psu-epl/epl-badge-access/README.md

# epl-badge-access

This is a mono-repo that contains hardwire designs, software, and documentation for a complete dual-band RFID access control system. This repo represents the work produced by ECE capstone team 17 during the 2021 - 2022 academic year.
