psu-epl/epl-badge-access/hardware/antenna/1356M/RFID-HF-antenna.pdf

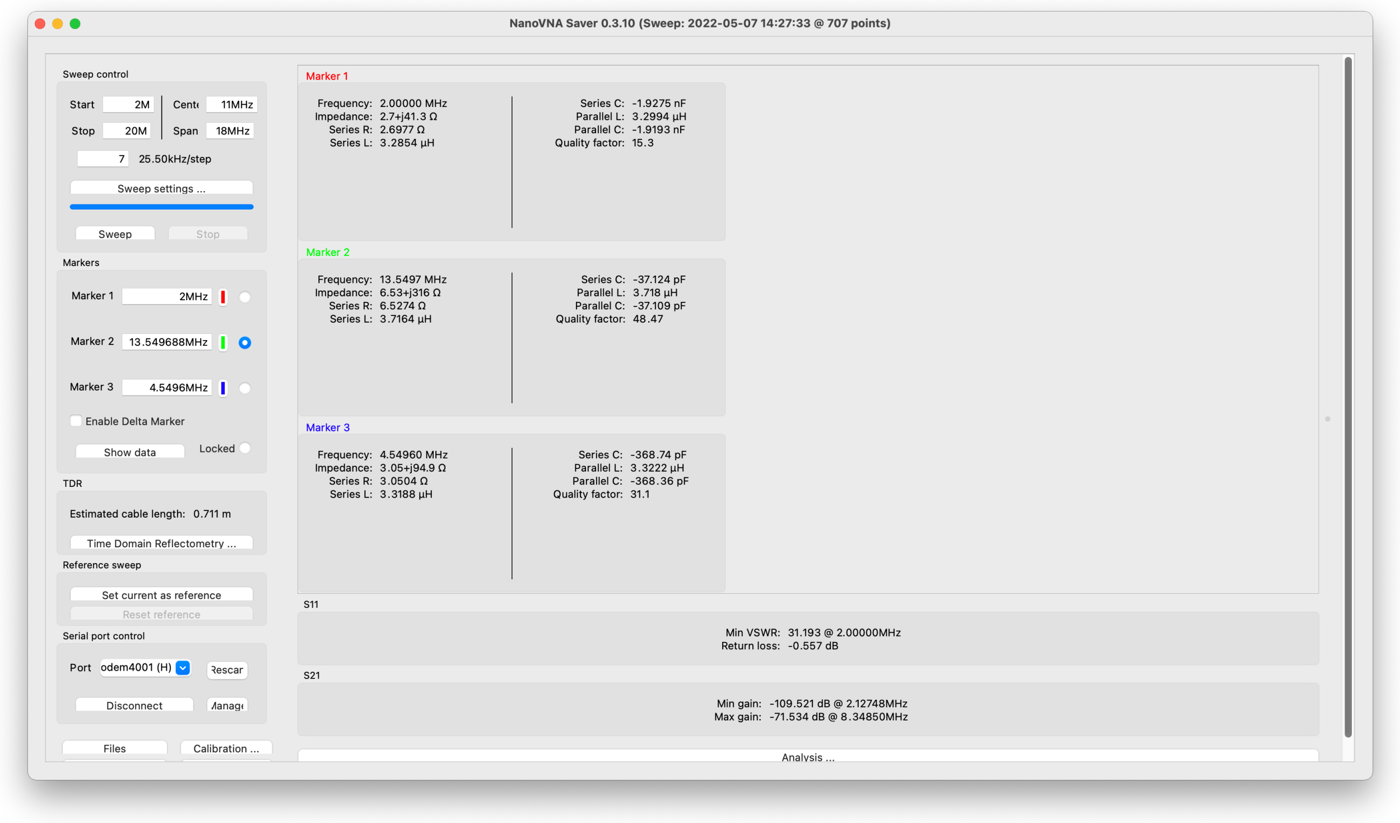
[picture p1: page 1]
