psu-epl/epl-badge-access/hardware/antenna/125k/RFID-LF-antenna.pdf

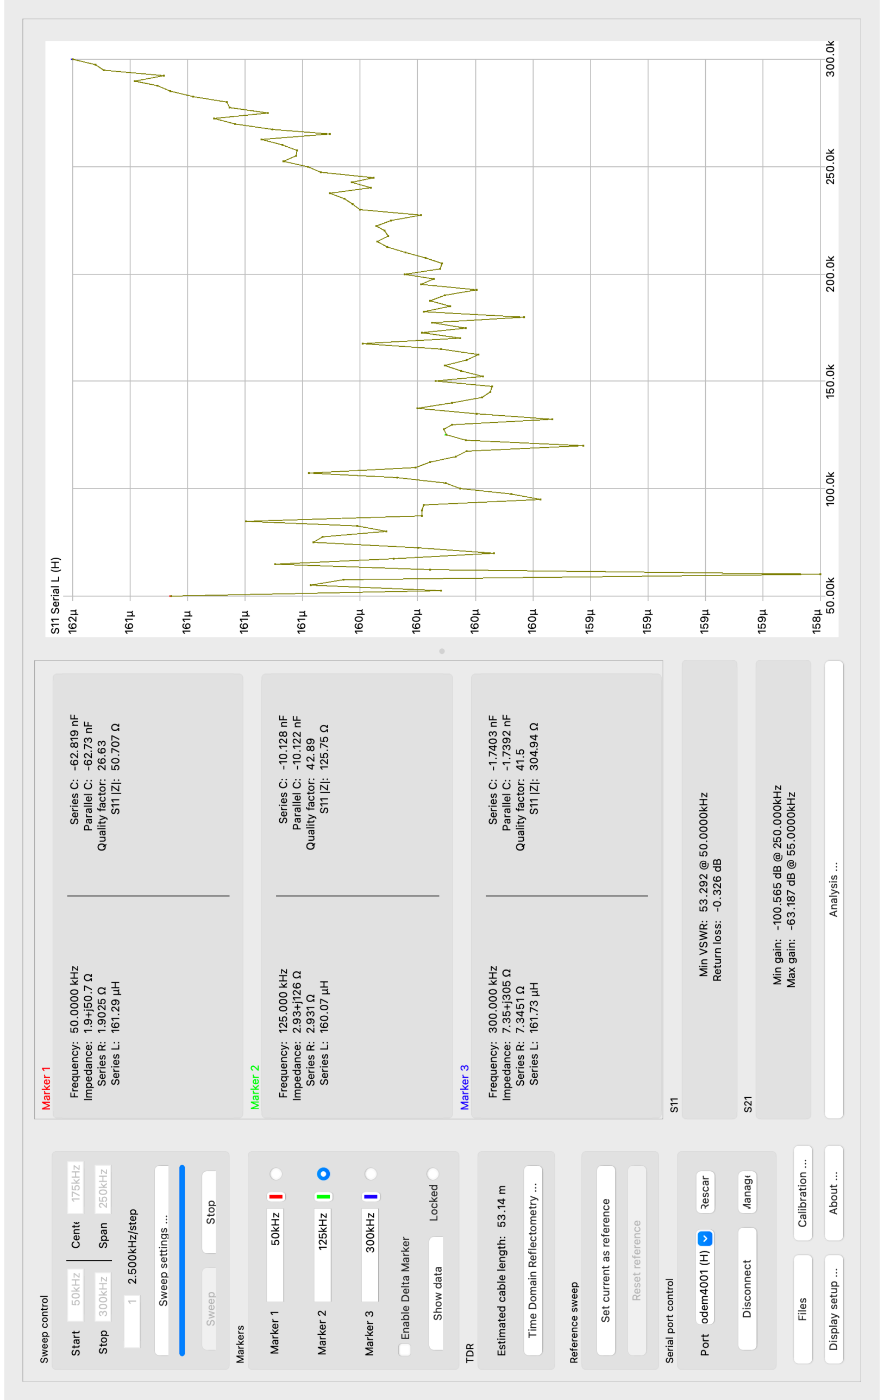
[picture p2: page 1]
