psu-epl/epl-badge-access/hardware/antenna/1356M/149110.xls

given
 | f | 13.56 | MHz
 | omega | 85199992.77 | 1/s
measured |  |  |  |  |  |  | 1 | 2 | 3 | 4
 | La | 2700 | nH |  |  |  | 0.09987919287 | 0.009975853167 | 0.2271431807 | 0.05159402454
 | Ca | 0.1 | pF
 | Ra | 2.2 | Ohm
required
 | Q | 19.8
 | Rmatch (Tx1-Tx2) | 43 | Ohm
 | fres filter | 14.400 | MHz | real: | 14.293 | MHz
calulated
 | Qa | 104.5636275
 | Rq | 4.71 | Ohm
 | Rpa | 4554.791613 | Ohm
Hilfswert |  | 4554.791613
chosen | L0 | 1000 | nH
 | C0 calculated | 122.2 | pF
chosen | C01 | 68 | pF
 | C02 | 56 | pF
 | Rtr | 698.3934612 | Ohm
 | Xtr | 117.7890312 | Ohm
 | C1 | 12.3 | pF
 | C2 | 88.7 | pF
