psu-epl/epl-badge-access/hardware/antenna/125k/RFID-LF-antenna.png

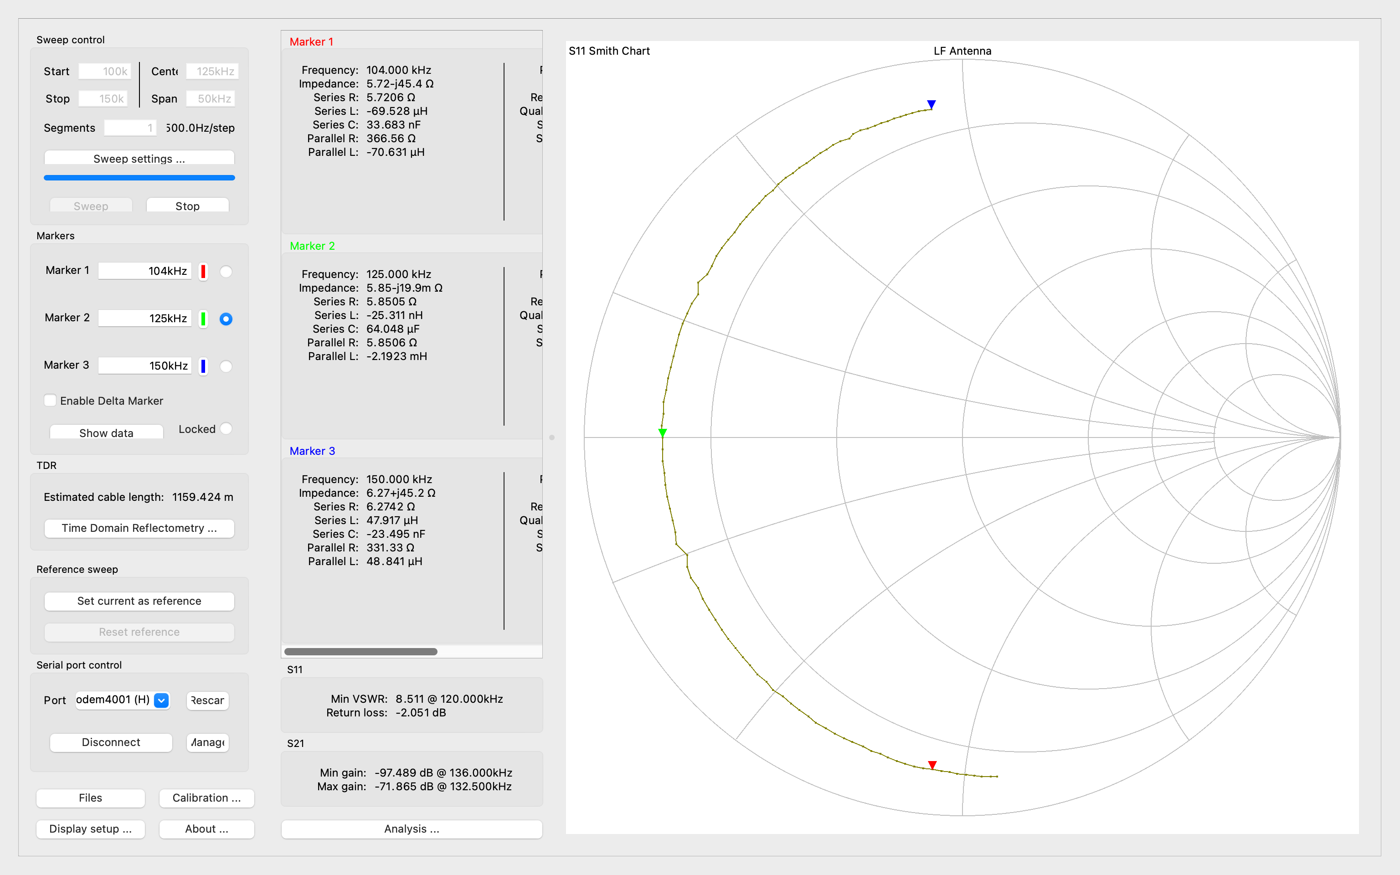
hardware/antenna/125k/RFID-LF-antenna.png
