psu-epl/epl-badge-access/hardware/antenna/1356M/rev0.1.0/VNA Measured L.pdf

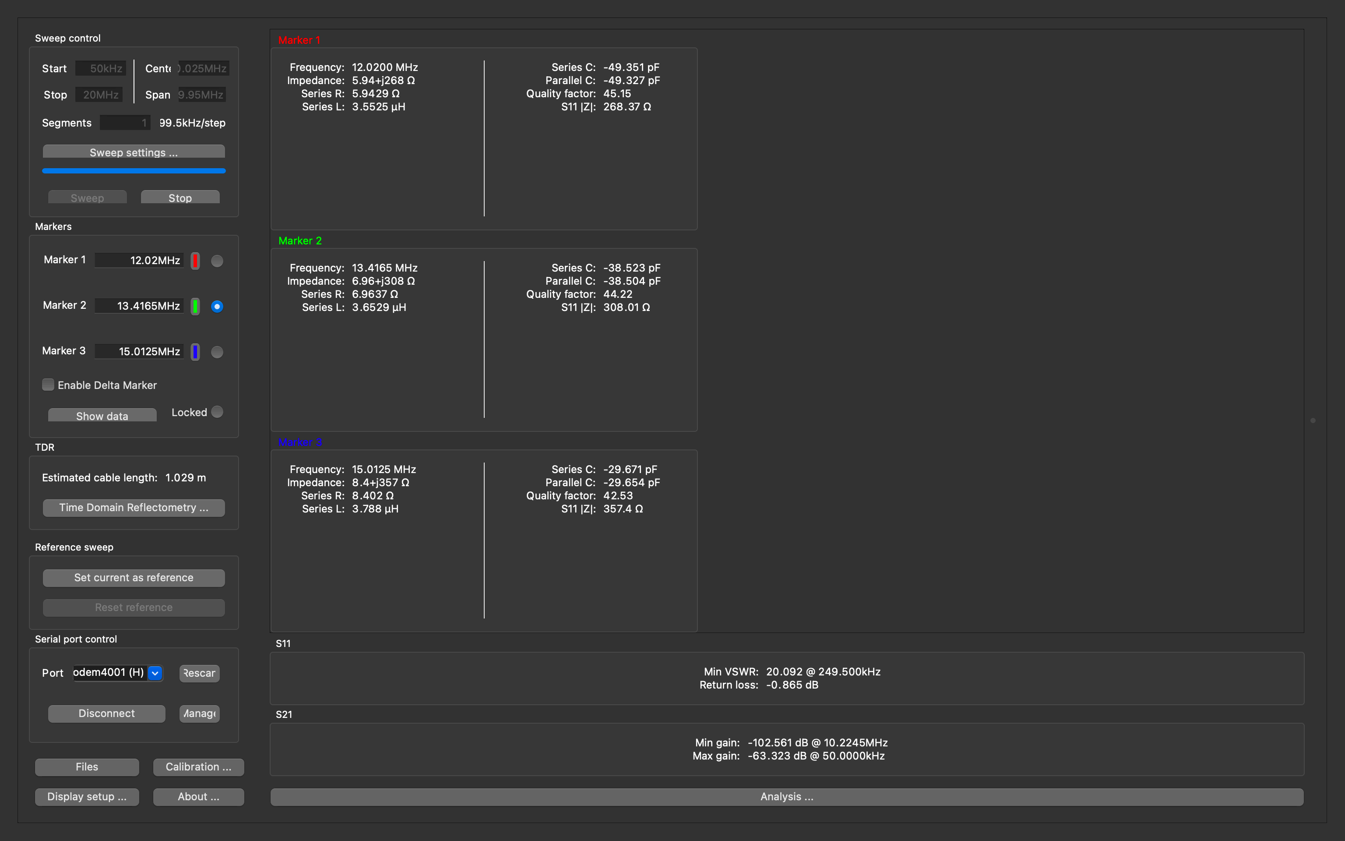
[picture p4: page 1]
