psu-epl/epl-badge-access/(threads)

Thread 3 (2022-05-07):

main board headers too tall

actaeon, 2022-05-07:
The profile of the main board headers (J1, J2 and L1) are too tall and won't fit in the enclosure. Need to find an alternative

Thread 4 (2022-05-07):

Missing Crx from receive path

actaeon, 2022-05-07:
The antenna design guide has a DC blocking cap referenced Crx in the receive path from the HF antenna. This was accidentally omitted from the design and needs to be fixed.

Thread 5 (2022-05-09):

on MFRC522, EA and I2C are backwards

actaeon, 2022-05-09:
Correct configuration is:

Pin 1 = I2C -> Connect to ground
pin 32 = EA -> pull up from 3.3V
