psu-epl/epl-badge-access/hardware/ltspice/125k/125k_reader_sim.asc

C1: cap; 162.1n
C2: cap; 1n
C3: cap; .0022µ
C4: cap; 1n
C5: cap; 1n
C6: cap; 1n
C7: cap; 1n
C8: cap; 1n
C9: cap; 1n
C10: cap; 1n
D1: diode; 1N4936
L1: ind2; 10µ; Rser=.1
L2: ind2; 1.62m
Q1: npn; 2N3904
R1: res; 1k
R2: res; 390k
R3: res; 82.5k
R4: res; 47.5k
R5: res; 100
R6: res; 2.67k
R7: res; 1.82k
R8: res; 1Meg
R9: res; 10k
R10: res; 15.5k
R11: res; 10k
R12: res; 10k
R13: res; 12k
R14: res; 10k
U1: LT1058
U2: LT1058
U3: LT1058
U4: LT1058
V1: voltage; PULSE(0 12 0 1n 1n 4u 8u)
V2: voltage; PWL REPEAT FOREVER (file="data.txt") ENDREPEAT
V3: voltage; 12
V4: voltage; 5
V5: voltage; 5
V6: voltage; 4.4
Named nets: 0, Vref, Vcc, VrefN
.tran 10m
K1 L1 L2 .1
.MODEL 1N4936 D  ( IS=830n RS=34.0m BV=400 IBV=5.00u
+ CJO=26.5p  M=0.333 N=2.46 TT=288n )
input impedance = 1M
