psu-epl/epl-badge-access/hardware/kicad/Labpass RFID Reader - Mez/Labpass RFID Reader - Mez.kicad_pcb

## KiCad design hardware/kicad/Labpass RFID Reader - Mez/Labpass RFID Reader - Mez.kicad_pcb (2022-06-10)

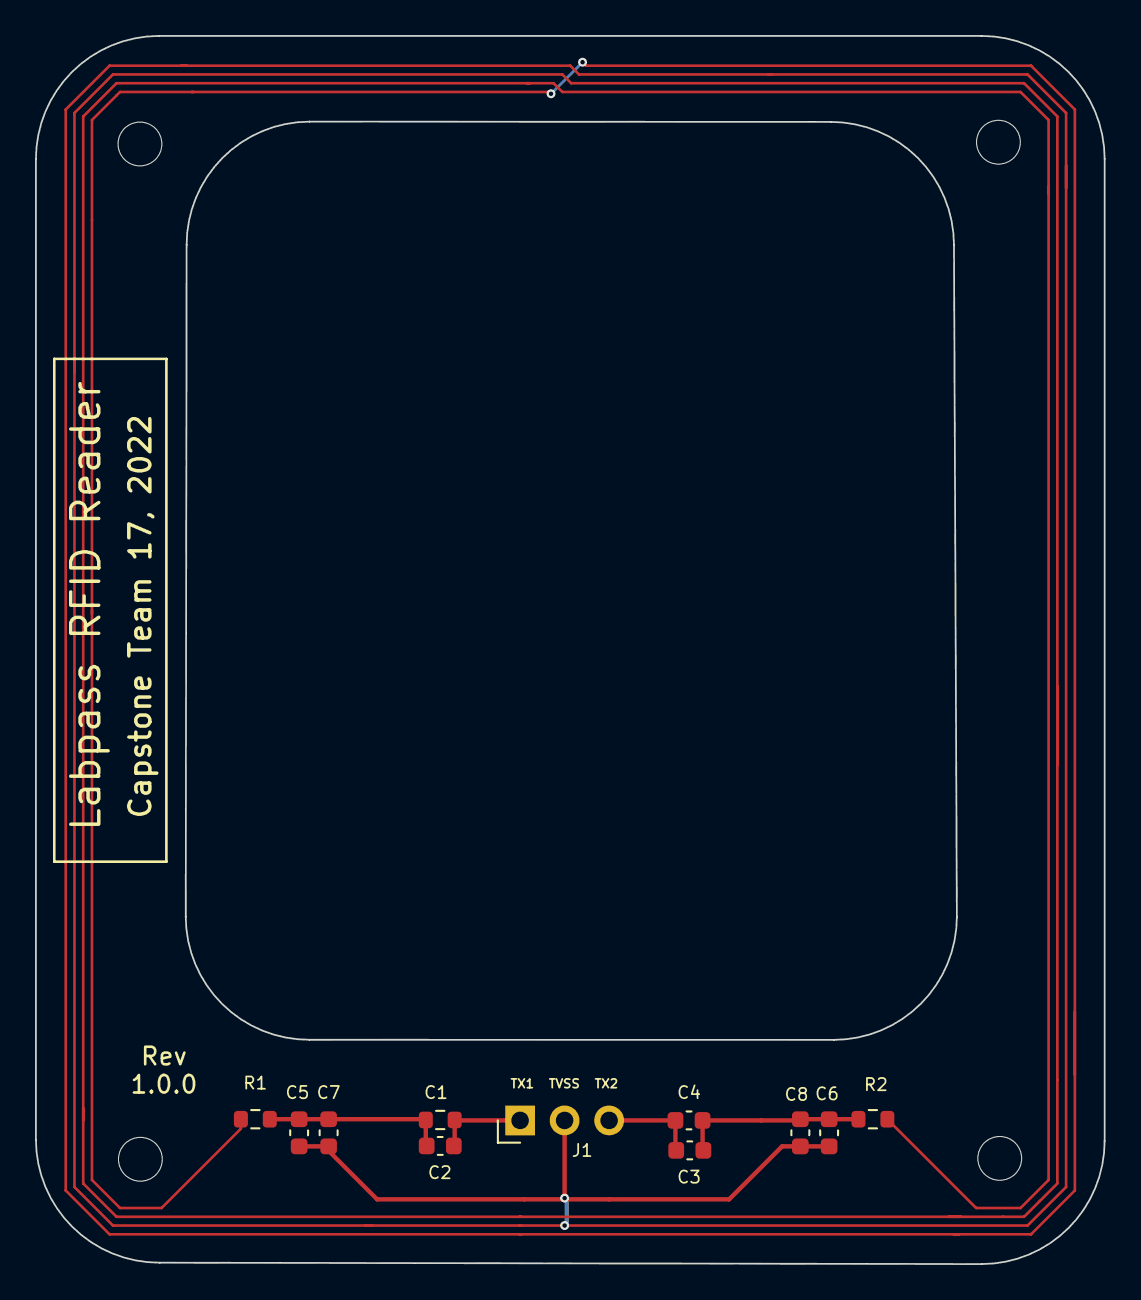
[picture p5: board Labpass RFID Reader - Mez.kicad_pcb from above]

Board: 2 copper layers, 61.0 x 70.1 mm, 11 parts (0 on the bottom side), 5 nets.

Parts:
C1: 11p; R_0603_1608Metric
C2, C3: NC; C_0603_1608Metric
C4: 11p; C_0603_1608Metric
C5, C6: 30p; C_0603_1608Metric
C7, C8: 32p; C_0603_1608Metric
J1: Conn_01x03_Male; PinHeader_1x03_P2.54mm_Horizontal
R1, R2: R_US; R_0603_1608Metric

Connections:
unnamed: C1.1, C2.1, J1.1
unnamed: C1.2, C2.2, C5.2, C7.1, R1.1
unnamed: C3.1, C4.1, J1.3
unnamed: C3.2, C4.2, C6.1, C8.2, R2.1
unnamed: C5.1, C6.2, C7.2, C8.1, J1.2, R1.2, R2.2
