psu-epl/epl-badge-access/hardware/kicad/Labpass RFID Reader/Labpass RFID Reader.kicad_pcb

## KiCad design hardware/kicad/Labpass RFID Reader/Labpass RFID Reader.kicad_pcb (2022-06-10)

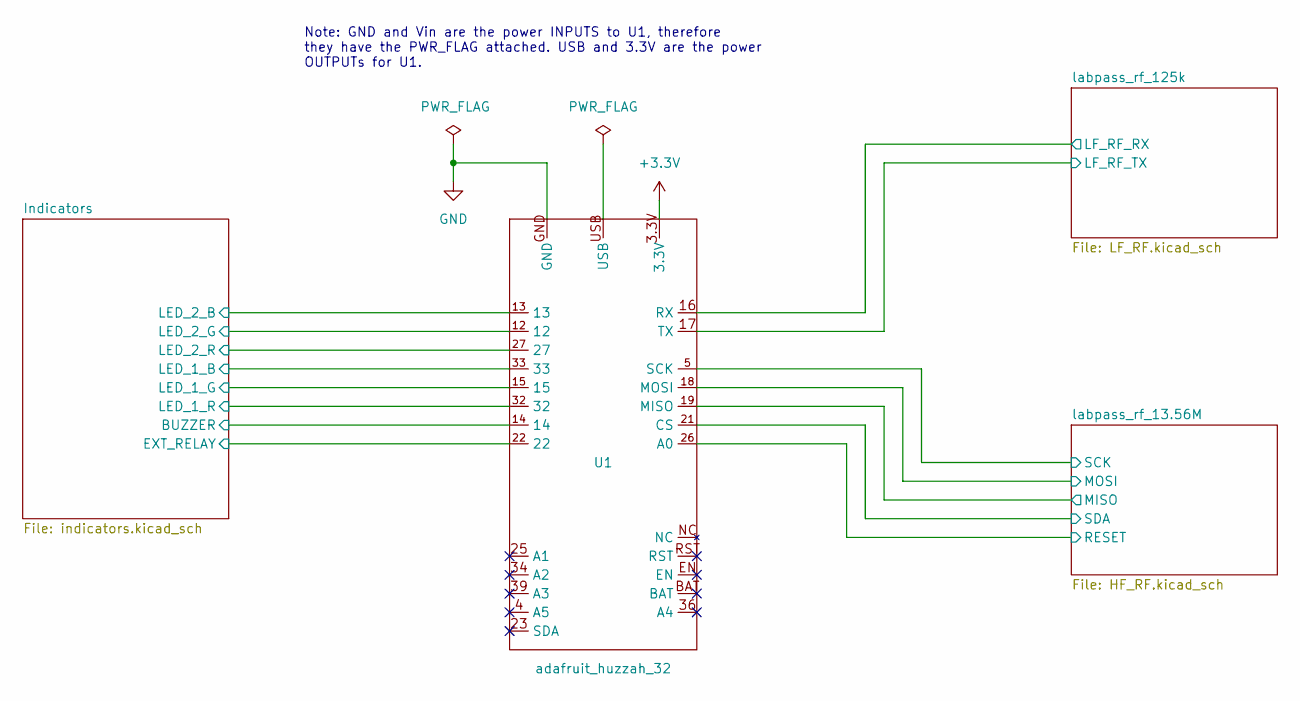
[picture p6: schematic Labpass RFID Reader.kicad_sch, Labpass RFID Reader - MCU]

Parts:
U1: adafruit_huzzah_32

Connections:
/Indicators/BUZZER: U1.14; also elsewhere on the board
/Indicators/EXT_RELAY: U1.22; also elsewhere on the board
/Indicators/LED_1_B: U1.33; also elsewhere on the board
/Indicators/LED_1_G: U1.15; also elsewhere on the board
/Indicators/LED_1_R: U1.32; also elsewhere on the board
/Indicators/LED_2_B: U1.13; also elsewhere on the board
/Indicators/LED_2_G: U1.12; also elsewhere on the board
/Indicators/LED_2_R: U1.27; also elsewhere on the board
/labpass_rf_13.56M/MISO: U1.19 (MISO); also elsewhere on the board
/labpass_rf_13.56M/MOSI: U1.18 (MOSI); also elsewhere on the board
/labpass_rf_13.56M/RESET: U1.26 (A0); also elsewhere on the board
/labpass_rf_13.56M/SCK: U1.5 (SCK); also elsewhere on the board
/labpass_rf_13.56M/SDA: U1.21 (CS); also elsewhere on the board
/labpass_rf_125k/LF_RF_RX: U1.16 (RX); also elsewhere on the board
/labpass_rf_125k/LF_RF_TX: U1.17 (TX); also elsewhere on the board

Notes on the sheet:
Note: GND and Vin are the power INPUTS to U1, therefore they have the PWR_FLAG attached. USB and 3.3V are the power OUTPUTs for U1.

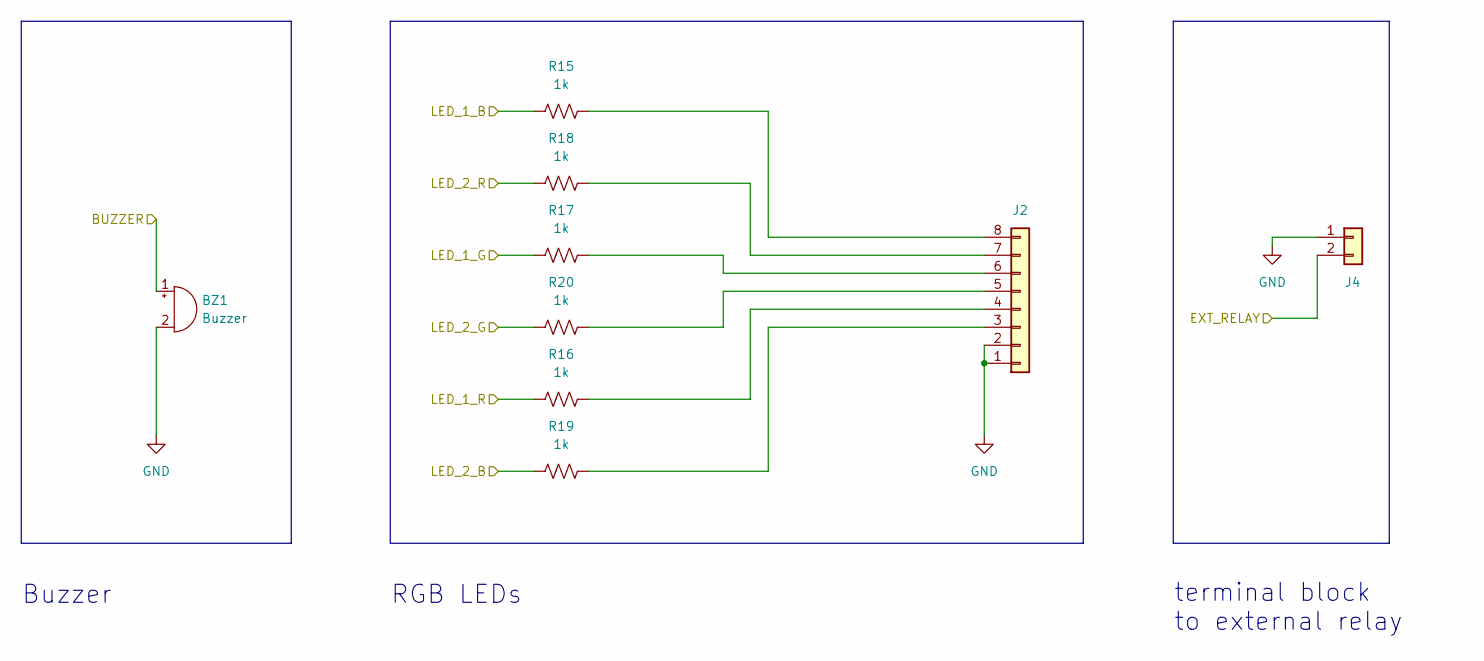
[picture p7: schematic indicators.kicad_sch]

Parts:
BZ1: Buzzer; buzzer
J2: Conn_01x08; PinHeader_2x04_P2.54mm_Horizontal
J4: Conn_01x02; Anytek NQ
R15, R16, R17, R18, R19, R20: 1k; R_0603_1608Metric

Connections:
/Indicators/BUZZER: BZ1.1 (-); also elsewhere on the board
/Indicators/EXT_RELAY: J4.2; also elsewhere on the board
/Indicators/LED_1_B: R15.1; also elsewhere on the board
/Indicators/LED_1_G: R17.1; also elsewhere on the board
/Indicators/LED_1_R: R16.1; also elsewhere on the board
/Indicators/LED_2_B: R19.1; also elsewhere on the board
/Indicators/LED_2_G: R20.1; also elsewhere on the board
/Indicators/LED_2_R: R18.1; also elsewhere on the board
unnamed: J2.3, R19.2
unnamed: J2.4, R16.2
unnamed: J2.5, R20.2
unnamed: J2.6, R17.2
unnamed: J2.7, R18.2
unnamed: J2.8, R15.2

Notes on the sheet:
RGB LEDs
terminal block to external relay
Buzzer

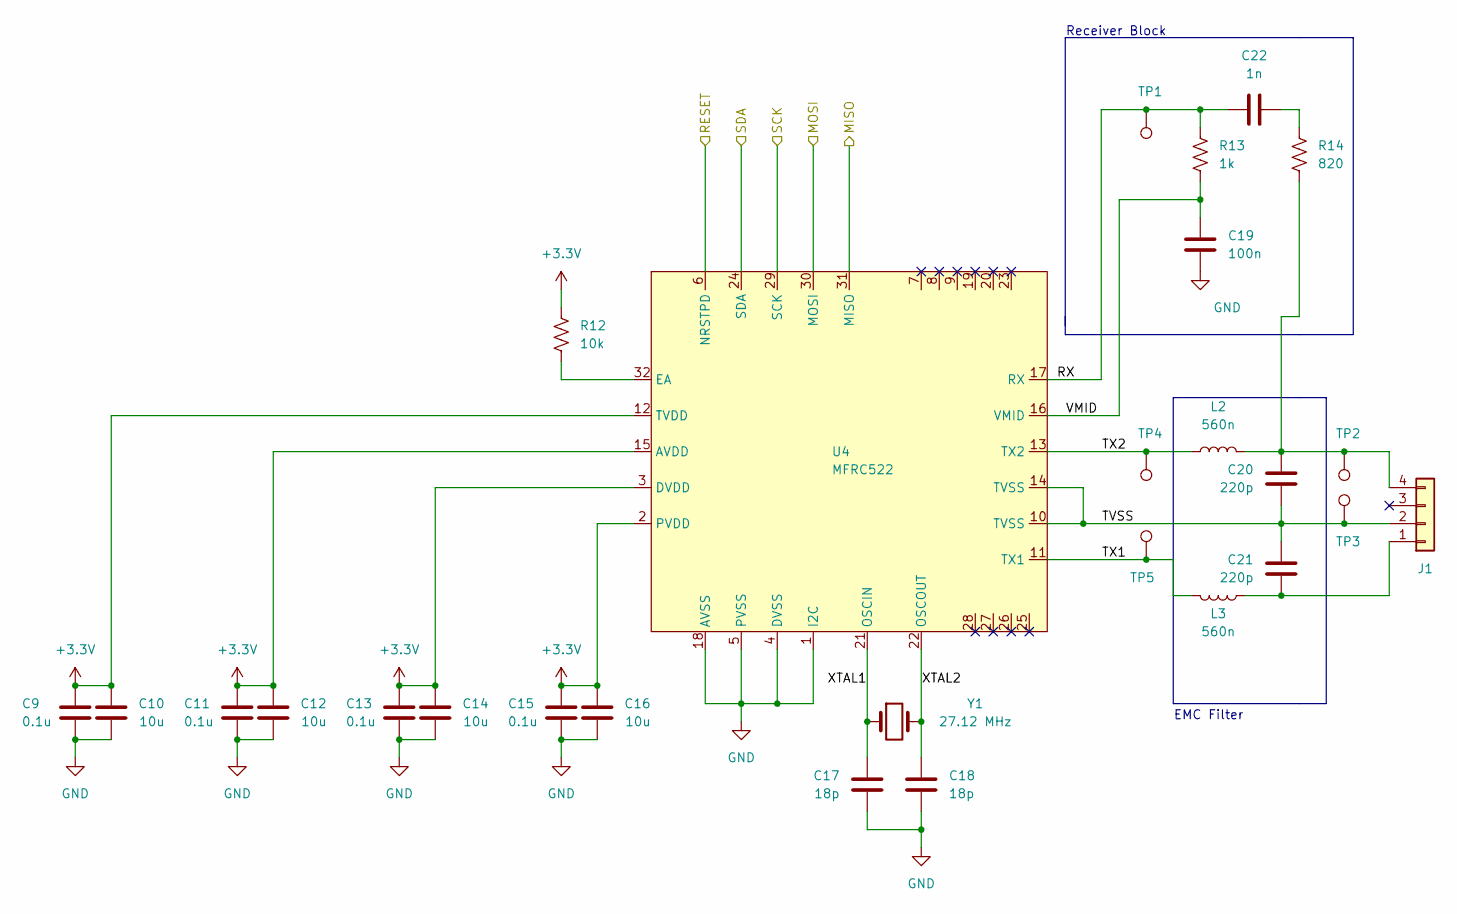
[picture p8: schematic HF_RF.kicad_sch, Labpass RFID Reader - High Frquency RF]

Parts:
C9, C11, C13, C15: 0.1u; C_0603_1608Metric
C10, C12, C14, C16: 10u; C_0603_1608Metric
C17, C18: 18p; C_0603_1608Metric
C19: 100n; C_0603_1608Metric
C20, C21: 220p; C_0603_1608Metric
C22: 1n; C_0603_1608Metric
J1: (no value)
L2, L3: 560n; L_1210_3225Metric
R12: 10k; R_0603_1608Metric
R13: 1k; R_0603_1608Metric
R14: 820; R_0603_1608Metric
TP1, TP2, TP3, TP4, TP5: TestPoint; TestPoint_Pad_1.0x1.0mm
U4: MFRC522; LQFP-32_5x5mm_P0.5mm
Y1: 27.12 MHz; Crystal_SMD_5032-2Pin_5.0x3.2mm

Connections:
/labpass_rf_13.56M/MISO: U4.31 (MISO); also elsewhere on the board
/labpass_rf_13.56M/MOSI: U4.30 (MOSI); also elsewhere on the board
/labpass_rf_13.56M/RESET: U4.6 (NRSTPD); also elsewhere on the board
/labpass_rf_13.56M/RX: C22.1, R13.1, TP1.1, U4.17 (RX)
/labpass_rf_13.56M/SCK: U4.29 (SCK); also elsewhere on the board
/labpass_rf_13.56M/SDA: U4.24 (SDA); also elsewhere on the board
/labpass_rf_13.56M/TVSS: C20.1, C21.2, J1.2, TP3.1, U4.10 (TVSS), U4.14 (TVSS)
/labpass_rf_13.56M/TX1: L3.2, TP5.1, U4.11 (TX1)
/labpass_rf_13.56M/TX2: L2.1, TP4.1, U4.13 (TX2)
/labpass_rf_13.56M/VMID: C19.1, R13.2, U4.16 (VMID)
/labpass_rf_13.56M/XTAL1: C17.2, U4.21 (OSCIN), Y1.1
/labpass_rf_13.56M/XTAL2: C18.1, U4.22 (OSCOUT), Y1.2
unnamed: C20.2, J1.4, L2.2, R14.1, TP2.1
unnamed: C21.1, J1.1, L3.1
unnamed: C22.2, R14.2
unnamed: R12.2, U4.32 (EA)

Notes on the sheet:
Receiver Block
EMC Filter

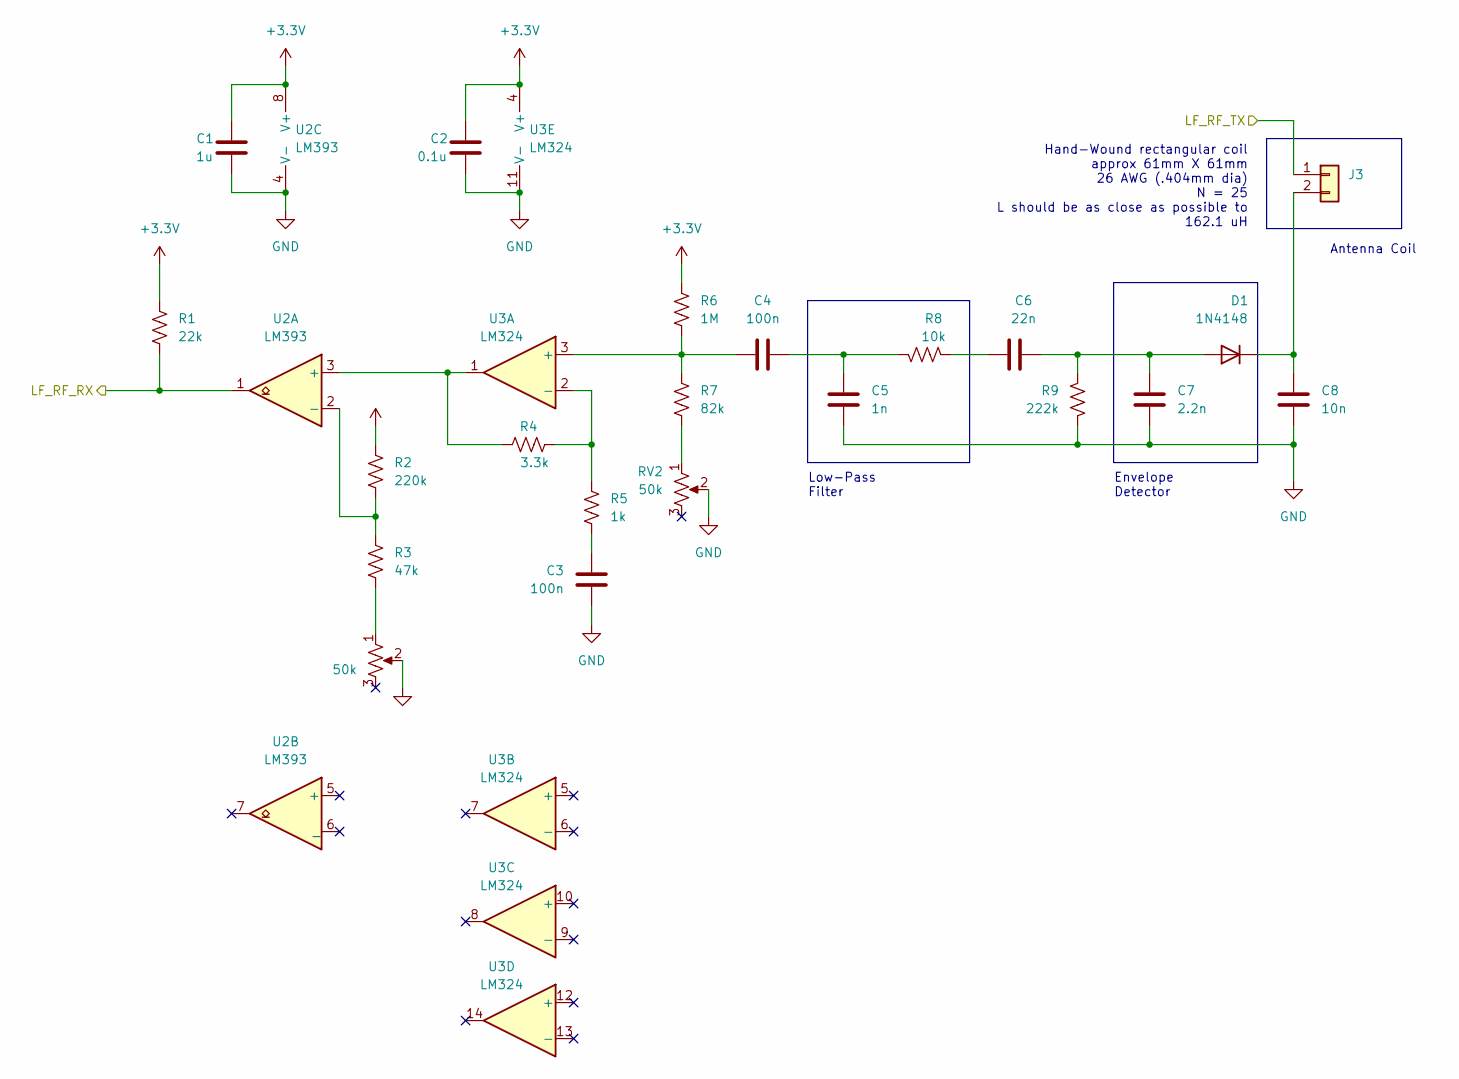
[picture p9: schematic LF_RF.kicad_sch, Labpass RFID Reader - Low Frquency RF]

Parts:
C1: 1u; C_0603_1608Metric
C2: 0.1u; C_0603_1608Metric
C3, C4: 100n; C_0603_1608Metric
C5: 1n; C_0603_1608Metric
C6: 22n; C_0603_1608Metric
C7: 2.2n; C_0603_1608Metric
C8: 10n; C_0603_1608Metric
D1: 1N4148; D_SOD-323F
J3: Conn_01x02; PinHeader_1x02_P2.54mm_Horizontal
R1: 22k; R_0603_1608Metric
R2: 220k; R_0603_1608Metric
R3: 47k; R_0603_1608Metric
R4: 3.3k; R_0603_1608Metric
R5: 1k; R_0603_1608Metric
R6: 1M; R_0603_1608Metric
R7: 82k; R_0603_1608Metric
R8: 10k; R_0603_1608Metric
R9: 222k; R_0603_1608Metric
RV1, RV2: 50k; TC33X
U2: LM393; SOIC-8_3.9x4.9mm_P1.27mm
U3: LM324; SO-14_3.9x8.65mm_P1.27mm

Connections:
/labpass_rf_125k/LF_RF_RX: R1.2, U2.1; also elsewhere on the board
/labpass_rf_125k/LF_RF_TX: J3.1; also elsewhere on the board
unnamed: C3.2, R5.2
unnamed: C4.1, R6.2, R7.1, U3.3 (+)
unnamed: C4.2, C5.1, R8.1
unnamed: C6.1, C7.1, D1.2 (A), R9.2
unnamed: C6.2, R8.2
unnamed: C8.1, D1.1 (K), J3.2
unnamed: R2.2, R3.1, U2.2 (-)
unnamed: R3.2, RV1.1
unnamed: R4.1, R5.1, U3.2 (-)
unnamed: R4.2, U2.3 (+), U3.1
unnamed: R7.2, RV2.1

Notes on the sheet:
Hand-Wound rectangular coil approx 61mm X 61mm 26 AWG (.404mm dia) N = 25 L should be as close as possible to 162.1 uH
Antenna Coil
Envelope Detector
Low-Pass Filter

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
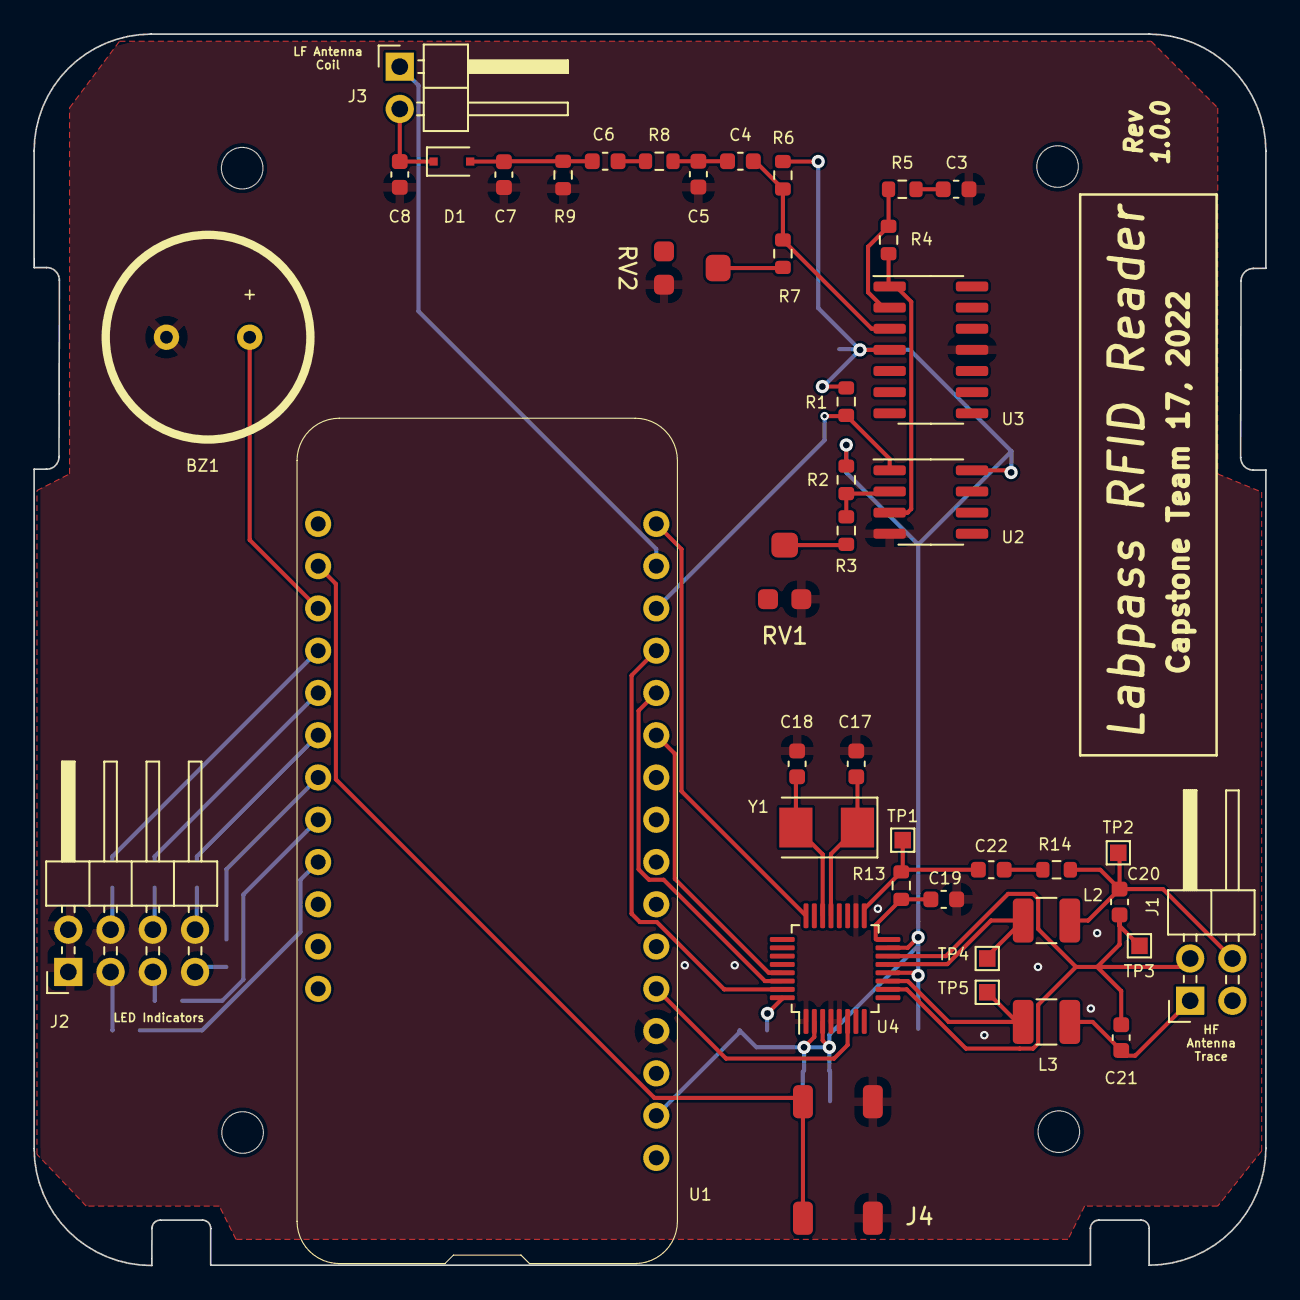
[picture p10: board Labpass RFID Reader.kicad_pcb from above]

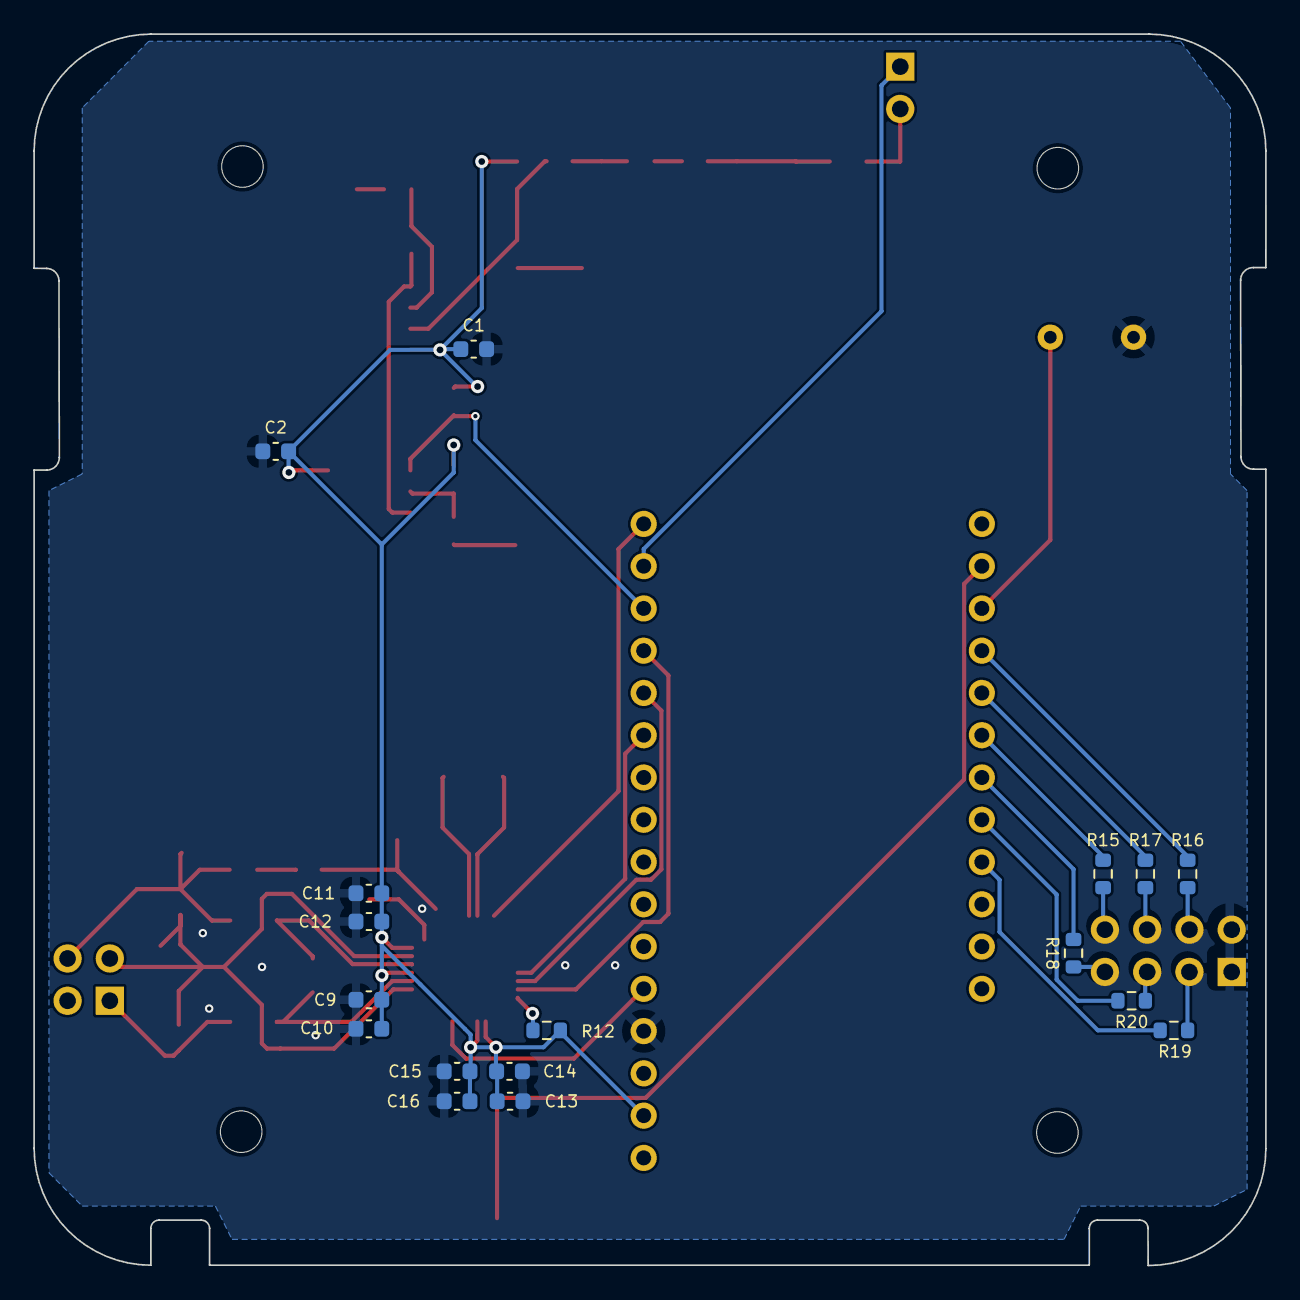
[picture p11: board Labpass RFID Reader.kicad_pcb from below]

Board: 2 copper layers, 74.0 x 74.0 mm, 60 parts (17 on the bottom side), 45 nets.
