psu-epl/epl-badge-access/hardware/kicad-old/Dual_Band_RFID_Reader/Dual_Band_RFID_Reader.kicad_pcb

## KiCad design hardware/kicad-old/Dual_Band_RFID_Reader/Dual_Band_RFID_Reader.kicad_pcb (2022-04-23, an earlier design)

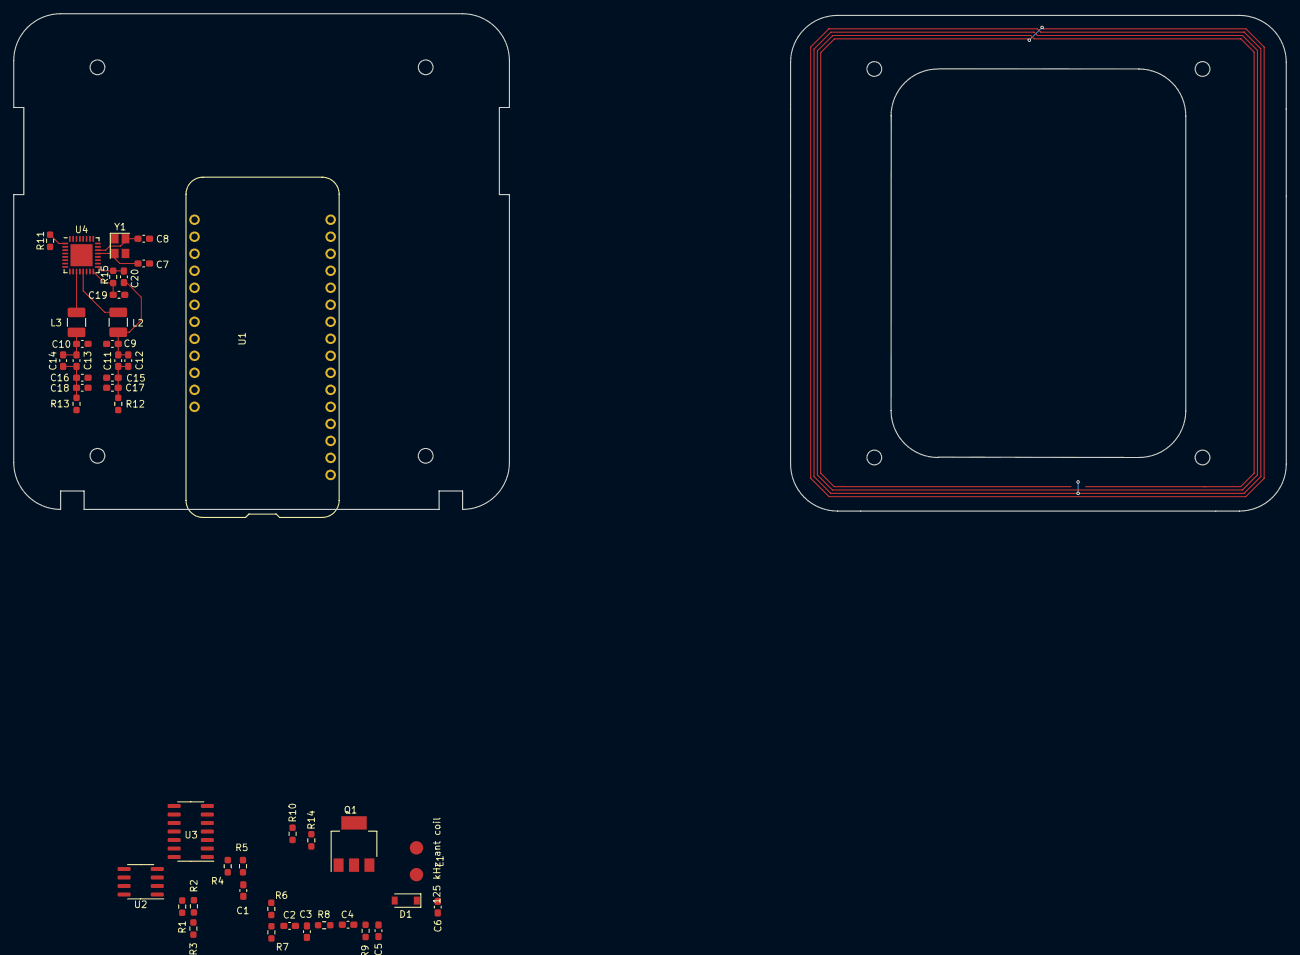
[picture p12: board Dual_Band_RFID_Reader.kicad_pcb from above]

Board: 2 copper layers, 45 parts (0 on the bottom side), 34 nets.

Parts:
C1, C2: 100 nF; C_0603_1608Metric_Pad1.08x0.95mm_HandSolder
C3: 1 nF; C_0603_1608Metric_Pad1.08x0.95mm_HandSolder
C4: 22 nF; C_0603_1608Metric_Pad1.08x0.95mm_HandSolder
C5: 2.2 nF; C_0603_1608Metric_Pad1.08x0.95mm_HandSolder
C6: 10n; C_0603_1608Metric_Pad1.08x0.95mm_HandSolder
C7, C8, C9, C10, C11, C12, C13, C14, C15, C16, C17, C18, C19, C20: C; C_0603_1608Metric_Pad1.08x0.95mm_HandSolder
D1: 1N4148; D_SOD-123
L1: 162 µH; LF Antenna Pads
L2, L3: INDUCTOR; L_1210_3225Metric_Pad1.42x2.65mm_HandSolder
Q1: BC517; SOT-223
R1: 22 kΩ; R_0603_1608Metric_Pad0.98x0.95mm_HandSolder
R2: 330 kΩ; R_0603_1608Metric_Pad0.98x0.95mm_HandSolder
R3: 120 kΩ; R_0603_1608Metric_Pad0.98x0.95mm_HandSolder
R4: 3.3 kΩ; R_0603_1608Metric_Pad0.98x0.95mm_HandSolder
R5, R10: 1 kΩ; R_0603_1608Metric_Pad0.98x0.95mm_HandSolder
R6: 1 MΩ; R_0603_1608Metric_Pad0.98x0.95mm_HandSolder
R7: 100 kΩ; R_0603_1608Metric_Pad0.98x0.95mm_HandSolder
R8: 10 kΩ; R_0603_1608Metric_Pad0.98x0.95mm_HandSolder
R9: 267 kΩ; R_0603_1608Metric_Pad0.98x0.95mm_HandSolder
R11, R12, R13, R15: 10k; R_0603_1608Metric_Pad0.98x0.95mm_HandSolder
R14: 56Ω; R_0603_1608Metric_Pad0.98x0.95mm_HandSolder
U1: Adafruit_Huzzah32; Adafruit Feather Huzzah 32
U2: LM393; SOIC-8_3.9x4.9mm_P1.27mm
U3: LM324; SOIC-14_3.9x8.7mm_P1.27mm
U4: MFRC522; QFN-32-1EP_5x5mm_P0.5mm_EP3.3x3.3mm
Y1: Crystal; Crystal_SMD_3225-4Pin_3.2x2.5mm_HandSoldering

Connections:
+3V3: R1.1, R2.1, R6.1, R11.1, U1.2 (3.3V), U4.2 (PVDD), U4.3 (DVDD), U4.12 (TVDD), U4.15 (AVDD)
+5V: R14.1, U1.26 (USB)
/High Frequency RF/CS: U1.16 (CS), U4.24 (SDA)
/High Frequency RF/MISO: U1.13 (MISO), U4.31 (MISO)
/High Frequency RF/MOSI: U1.12 (MOSI), U4.30 (MOSI)
/High Frequency RF/RST: U1.23 (RST), U4.6 (NRSTPD)
/High Frequency RF/SCK: U1.11 (SCK), U4.29 (SCK)
/Low Frequency RF/LF_RF_RX: R1.2, U1.14 (RX), U2.1
/Low Frequency RF/LF_RF_TX: R10.2, U1.15 (TX)
GND: C1.1, C3.1, C5.2, C6.2, C7.2, C8.2, C19.2, R3.2, R7.2, R9.2, U1.4 (GND), U4.4 (DVSS), U4.5 (PVSS), U4.14 (TVSS), U4.18 (AVSS), U4.32 (EA)
unnamed: C1.2, R5.1
unnamed: C2.2, C3.2, R8.1
unnamed: C4.1, R8.2
unnamed: C10.2, C13.2, C14.2, L3.2
unnamed: C11.1, C12.1, C15.2, C17.2, R12.2
unnamed: C9.1, C11.2, C12.2, C20.1, L2.2
unnamed: C13.1, C14.1, C16.1, C18.1, R13.2
unnamed: C4.2, C5.1, D1.2 (A), R9.1
unnamed: C6.1, D1.1 (K), L1.1
unnamed: Q1.2 (B), R10.1
unnamed: Q1.1 (C), R14.2
unnamed: L1.2, Q1.3 (E)
unnamed: R4.1, U2.3 (+), U3.1
unnamed: R2.2, R3.1, U2.2 (-)
unnamed: C2.1, R6.2, R7.1, U3.3 (+)
unnamed: R4.2, R5.2, U3.2 (-)
unnamed: R11.2, U4.1 (I2C)
unnamed: C7.1, U4.21 (OSCIN), Y1.3
unnamed: C8.1, U4.22 (OSCOUT), Y1.1
unnamed: C20.2, R15.2, U4.17 (RX)
unnamed: C9.2, C10.1, C15.1, C16.2, C17.1, C18.2, R12.1, R13.1, U4.10 (TVSS)
unnamed: L3.1, U4.11 (TX1)
unnamed: L2.1, U4.13 (TX2)
unnamed: C19.1, R15.1, U4.16 (VMID)
