psu-epl/epl-badge-access/(commit log)

2022-02-21 Initial commit of 125k hardware + software design
    Note: Documentation included separately using the github
    wiki located at:
    https://github.com/psu-epl/epl-badge-access/wiki
    * Working 125k rfid reader circuit schematic captures in kicad
    * LF antenna VNA analysis
    * Relevant datasheets
    * LTSpice simulations
    * Multi-Threaded software module for reading 125k / driving
    the antenna circuit
    [149110.xls, Dual_Band_RFID_Reader.kicad_pcb, Dual_Band_RFID_Reader.kicad_sch, low_freq_rf.kicad_sch]
2022-02-22 Add the full PlatformIO directory for the reader software
    See the README for a complete explanation, but this is a complete
    codebase for an embedded system using Visual Studio Code along
    with the PlatformIO extension.
    This is a much nicer exaperience than using the Arduino IDE.
2022-03-07 Add HF and LF analog RF drivers
2022-03-07 Antenna files
    The NXP design doc AN1445 (Antenna design for MFRC522) contains
    the recommended impedance matching circuitry and calculations. NXP
    makes an excel spreadsheet available to make the calculations a
    little easier, but I refuse to use excel so here we are.
    I made a matlab script to do the calc necessar for the HF impedance
    matching.
2022-03-07 First pass at HF and LF schematics
    [Dual_Band_RFID_Reader.kicad_sch, high_freq_rf.kicad_sch, low_freq_rf.kicad_sch]
2022-03-09 * Move task spawn into RF classes * consolidate threading; HF doesn't need two
    [low_freq.cpp, low_freq.h, main.cpp]
2022-03-14 move sheet template to kicad project folder
    [Dual_Band_RFID_Reader.kicad_sch, high_freq_rf.kicad_sch, low_freq_rf.kicad_sch]
2022-03-14 Remove IRQ hw line from MFRC522, it's not useful
    [Dual_Band_RFID_Reader.kicad_sch, high_freq_rf.kicad_sch]
2022-04-02 adding Mousa's board work to branch
    [Dual_Band_RFID_Reader.kicad_pcb, Dual_Band_RFID_Reader.kicad_sch, high_freq_rf.kicad_sch, low_freq_rf.kicad_sch]
2022-04-03 Board Layout WIP
    * Added correct footprint for the components that were
    producing errors
    * added HF antenna trace on board periphery
    * added pads for the LF antenna coil to be connected later
    * corrected all the DRC errors
    * completed HF layout
    [Dual_Band_RFID_Reader.kicad_pcb, Dual_Band_RFID_Reader.kicad_sch, high_freq_rf.kicad_sch, low_freq_rf.kicad_sch]
2022-04-15 PCB Check
2022-04-16 Updates traces
    [Dual_Band_RFID_Reader.kicad_pcb, Dual_Band_RFID_Reader.kicad_sch, high_freq_rf.kicad_sch, low_freq_rf.kicad_sch]
2022-04-16 Updates traces_1
    [Dual_Band_RFID_Reader.kicad_pcb]
2022-04-16 Update traces_2
    [Dual_Band_RFID_Reader.kicad_pcb]
2022-04-17 Re-do kicad all ki-cad files using 6.04 stable *sigh*
    [Dual_Band_RFID_Reader.kicad_pcb, Dual_Band_RFID_Reader.kicad_sch, HF_RF.kicad_sch, LF_RF.kicad_sch, Labpass RFID Reader - Mez.kicad_pcb, Labpass RFID Reader - Mez.kicad_sch, Labpass RFID Reader.kicad_pcb, Labpass RFID Reader.kicad_sch]
2022-04-18 Re-do board design using kicad 6.04 stable
    [HF_RF.kicad_sch, LF_RF.kicad_sch, Labpass RFID Reader.kicad_pcb, Labpass RFID Reader.kicad_sch, indicators.kicad_sch]
2022-04-19 Polish reposition pin headers to clear mez board
    [HF_RF.kicad_sch, LF_RF.kicad_sch, Labpass RFID Reader - Mez.kicad_pcb, Labpass RFID Reader - Mez.kicad_sch, Labpass RFID Reader.kicad_pcb, Labpass RFID Reader.kicad_sch, indicators.kicad_sch]
2022-04-20 Add RGB LEDs with 4 wires
    [Labpass RFID Reader.kicad_pcb, Labpass RFID Reader.kicad_sch, indicators.kicad_sch]
2022-04-23 last-minute fixes
    [Labpass RFID Reader - Mez-B_Cu.gbl, Labpass RFID Reader - Mez-B_Mask.gbs, Labpass RFID Reader - Mez-B_Silkscreen.gbo, Labpass RFID Reader - Mez-Edge_Cuts.gm1, Labpass RFID Reader - Mez-F_Cu.gtl, Labpass RFID Reader - Mez-F_Mask.gts, Labpass RFID Reader - Mez-F_Silkscreen.gto, Labpass RFID Reader - Mez-job.gbrjob]
2022-04-26 kicad backups
2022-04-26 Create CAD
2022-05-10 add missing dc blocking cap to HF path
    [HF_RF.kicad_sch, LF_RF.kicad_sch, Labpass RFID Reader.kicad_pcb, Labpass RFID Reader.kicad_sch]
2022-05-10 Several fixes
    * EA and I2C were backwards
    * Adding missing Crx into HF receive path
    * Better header size and placement
    [HF_RF.kicad_sch, LF_RF.kicad_sch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]
2022-05-15 Additional Changes
    * remove transistor on LF path and power coil directly
    from ESP TX pin at 3.3V
    * add some test points around the HF path
    * add some cheap pots on LF for tuning the amplifier bias
    and comparator threshold
    [HF_RF.kicad_sch, LF_RF.kicad_sch, Labpass RFID Reader.kicad_pcb, Labpass RFID Reader.kicad_sch]
2022-05-16 Add terminal block for gpio to ext relay
    [HF_RF.kicad_sch, LF_RF.kicad_sch, Labpass RFID Reader.kicad_pcb, Labpass RFID Reader.kicad_sch, indicators.kicad_sch]
2022-05-16 bump rev to 1.0.0
    [Labpass RFID Reader - Mez.kicad_pcb, Labpass RFID Reader - Mez.kicad_sch, Labpass RFID Reader.kicad_pcb, Labpass RFID Reader.kicad_sch, indicators.kicad_sch]
2022-05-16 Add back the mounting holes
    [Labpass RFID Reader - Mez.kicad_pcb, Labpass RFID Reader.kicad_pcb]
2022-05-18 tweak incorrect designation for jumper
    [HF_RF.kicad_sch, Labpass RFID Reader.kicad_sch]
2022-05-26 add some text to the fab layer for placement
    [Labpass RFID Reader - Mez.kicad_pcb, Labpass RFID Reader.kicad_pcb]
2022-06-10 Final rev 1.0.0
    [Labpass RFID Reader - Mez.kicad_pcb, Labpass RFID Reader - Mez.kicad_sch, Labpass RFID Reader.kicad_pcb]
